InnuendoPi/Spundomat/README.md

# Spundomat

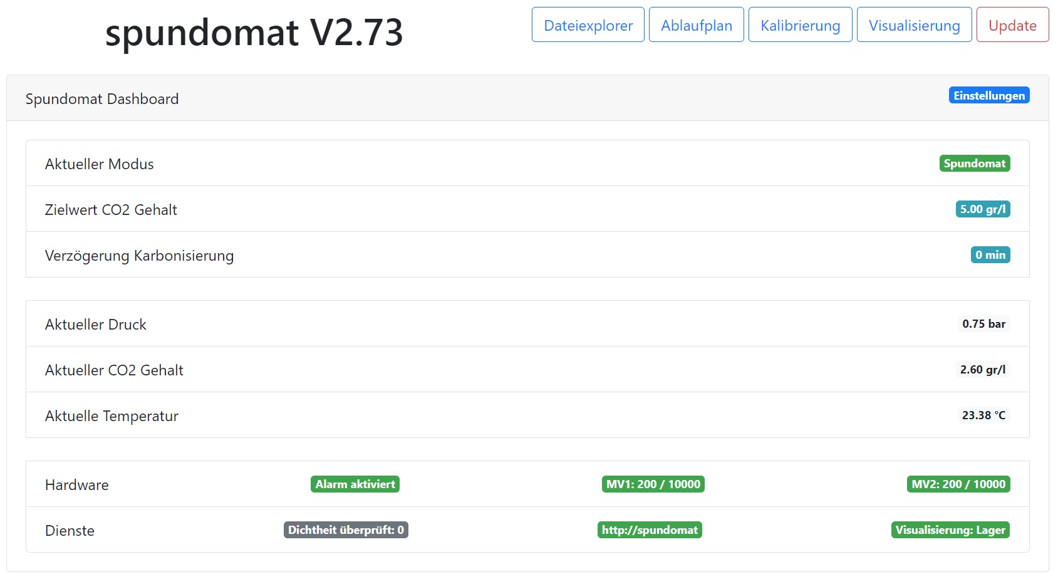
[picture p1: docs/img/Spundomat01.jpg]
ov1


Dokumentation unter: <https://innuendopi.github.io/Spundomat/>

## Infos zum Quellcode

Bibliotheken: (Stand ab Version 2.85, 02.2025)

- ESP8266 3.2 (LittleFS)
- VSCode 1.96 Arduino 0.6 Arduino CLI 1.0.4\
- VSCode plugin ESP8266LittleFS based on ESP8266fs\
- ArduinoJSON 7.2
- InfluxDB 3.13
- WiFiManager 2.0
- LiquidCrystal_PCF8574 2.2
- RotaryEncoder 1.5.3
- InnuTicker
- InnuFramework

Flash size 4MB (FS:2MB OTA:~1019kB)

## Changelog

Version 2.85

- Test:         Modul Steuerung Fermenter reaktiviert
- Update:       Dallas DS18B20 Bibliothek 4.0.3
- Korrektur:    Gehäuse Spundomat 2
- Neu:          Gehäuse Spundomat 2
- Update:       Arduino cores 3.2
- Update:       ArduinoJSON 7.2
- Fix:          Ablaufplan Namen wurden fehlerhaft abgespeichert
- Geändert:     Lesen und Speichern im eeprom überarbeitet (typedef struct)
- Geändert:     Änderungen der Konfiguration im WebIf werden nun als JSON übertragen
- Neu:          Überprüfung aller Eingabe im Web interface (client side validation). Anm.: nicht in den Tabellen Ablaufplan
- Neu:          Zeitserver integriert
- Geändert:     InnuFramework aktualisiert
- Neu:          SerializeJSON jQuery Plugin eingefügt

Version 2.83f

- Update:       ArduinoJSON API 7
- Fix:          Free memory for _currentArgs after request has been handled in WebServer. (#9077)
- Fix:          ESP8266WebServer - fix possible memory leak in request argument handling (#9076)
- Neu:          Display Timeout (User Bierdrohne)
- Fix:          JSON Größe misc
- Fix:          JSON Influx User Password an WebIf fehlerhaft
- Geändert:     Parametertyp Influx User/Bucket und Password/Token
- Fix:          Visualisierung

Version 2.82

- Fix:          WebUpdate

Version 2.81

- Geändert:     WebUpdate Standardverbindung SSL
- Geändert:     Speicherverbrauch WebUpdate optimiert
- Geändert:     DateiUpdate
- Neu:          Log Datei WebUpdate (webUpdateLog.txt)

Version 2.80

- Fix:          github MFLN Verprobung WebUpdate
- Fix:          WebUpdate
- Erneuert:     Zertifikate SSL

Version 2.79 Release

- Update:     InnuFramework

Version 2.78

- Fixed:      Arduino ESP8266 core: Fix for occasional timeout issues #8944 (net error timeout - WebIf Fehler)
- Fixed:      Arduino ESP8266 core: Fix for dangerous relocation: j: cannot encode #8925
- Changed:    Arduino ESP8266 core: Add support WiFiClientSecure TCP KeepAlive #8940
- Changed:    Cache control WebIf (no-cache, expires 0)
- Update:     InnuFramework

Version 2.77

- Update:   ESP8266 cores, Arduino Bibliotheken
- Update:   JQuery 3.7.0
- Fixed:    cache handling
- Fixed:    page load unknown length
- Fixed:    Fehler gpio
- Changed:  GPIO Modus (Piezo, Ventilator) ersetzt durch Pizeo Buzzer ein/aus
- Removed:  alte goto sub statements

Version 2.76

- Optimize: CleanUp, Framework
- Fixed:    Fehler speichern Ablaufplan

Version 2.75

- Optimize: Framework: WLAN reconnect, readConfig

Version 2.74

- Fixed:    Fehler WebIf Visualisierung behoben
- Update:   ESP8266 cores
- Update:   bootstrap 4.6.2
- Optimize: Konfiguration Backup und Restore
- Added:    DevBranch
- Update:   ESP8266 Arduino 3.1.2
- Optimize: Web Interface
- Optimize: Framework
- Update:   VSCode 1.76
