InnuendoPi/Spundomat/docs/img/Ablaufplan1.jpg

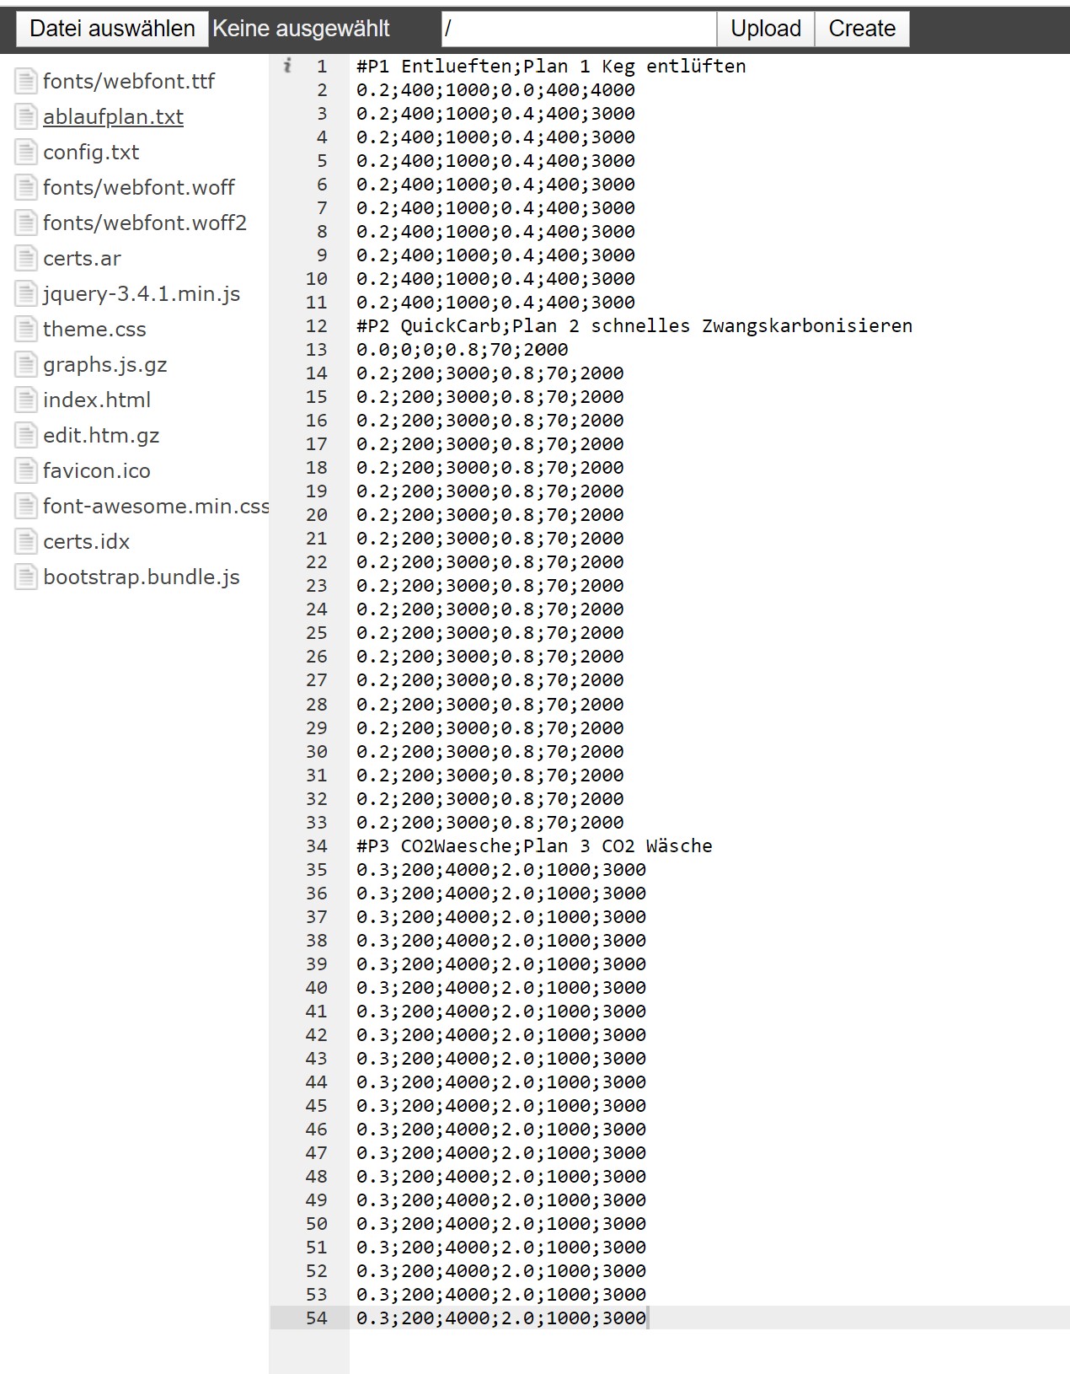
docs/img/Ablaufplan1.jpg
