InnuendoPi/Spundomat/docs/img/co2waesche.jpg

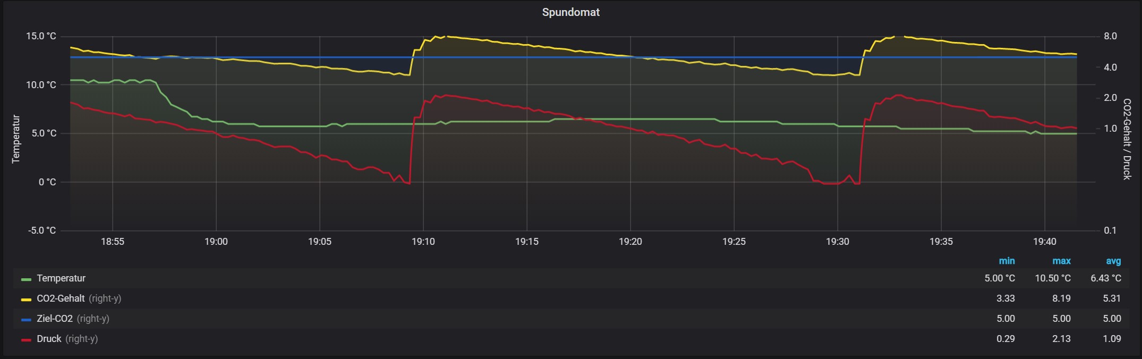
docs/img/co2waesche.jpg
