InnuendoPi/Spundomat/docs/img/P1100002_Bildgröße ändern.JPG

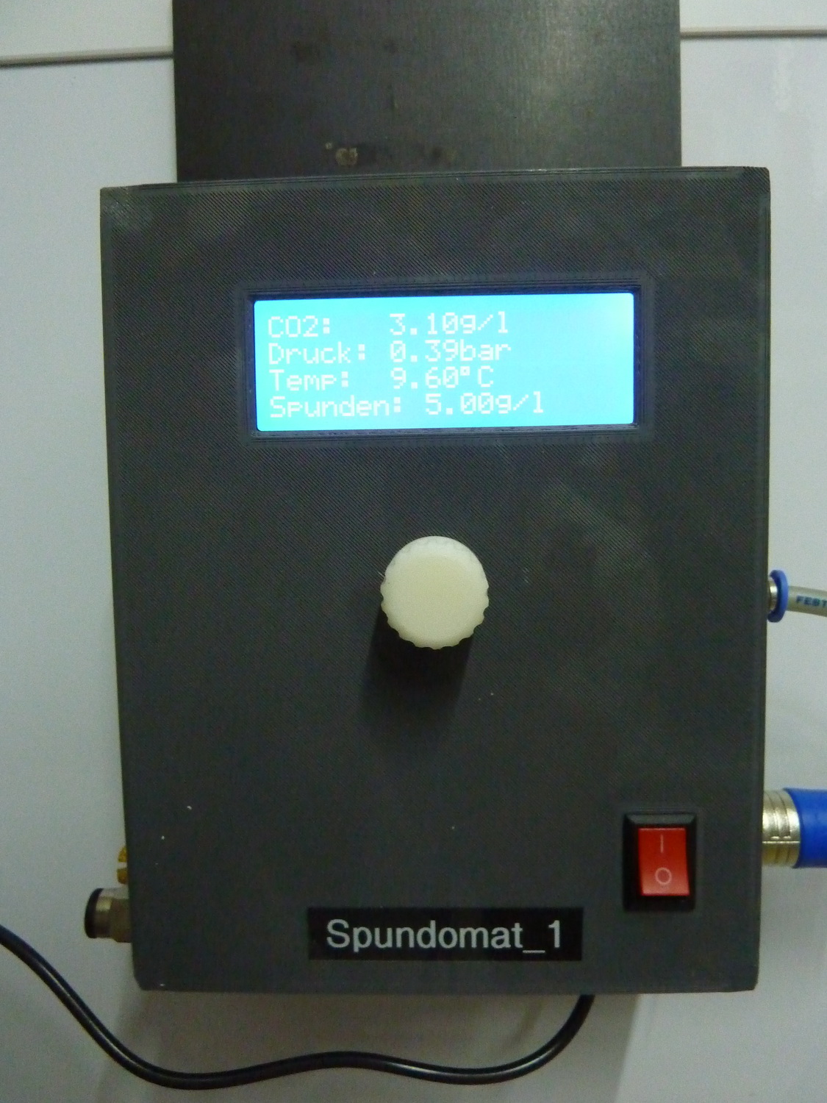
docs/img/P1100002_Bildgröße ändern.JPG
