InnuendoPi/Spundomat/docs/img/P1100003_Bildgröße ändern.JPG

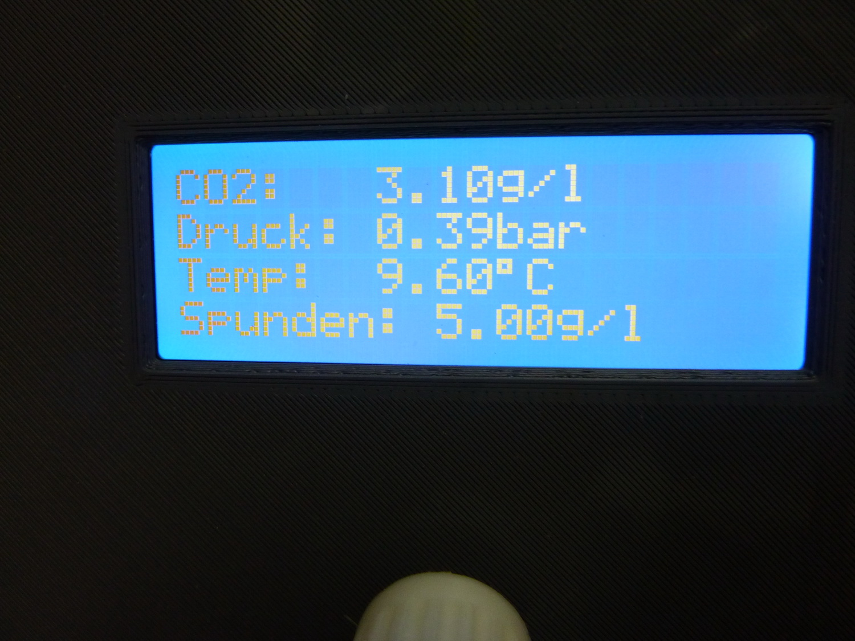
docs/img/P1100003_Bildgröße ändern.JPG
