InnuendoPi/Spundomat/docs/img/P1100004_Bildgröße ändern.JPG

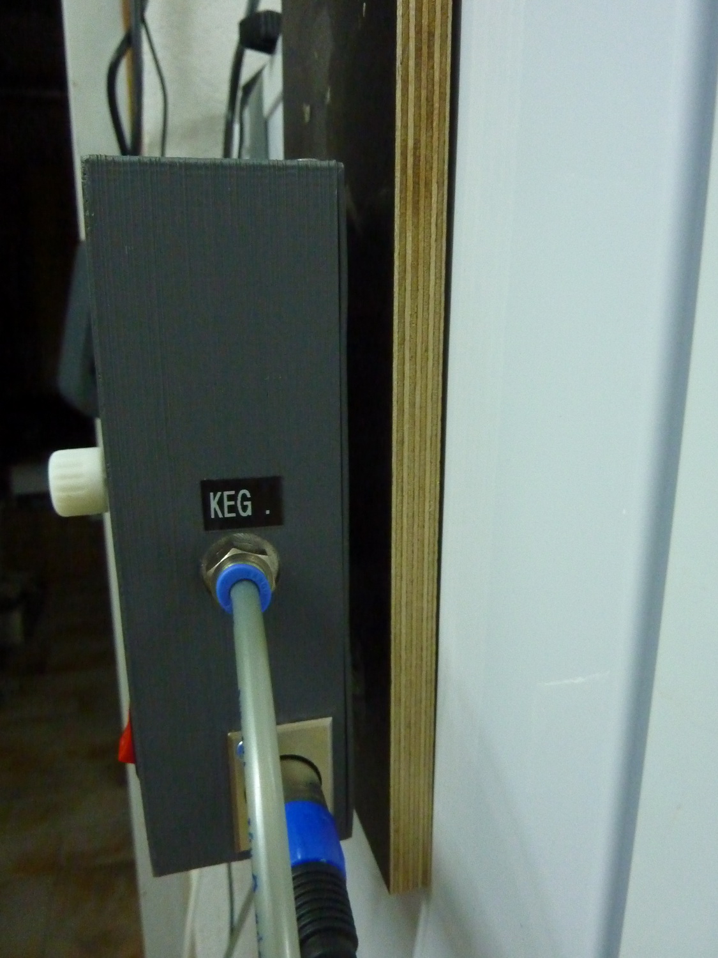
docs/img/P1100004_Bildgröße ändern.JPG
