InnuendoPi/Spundomat/docs/img/quickcarb.jpg

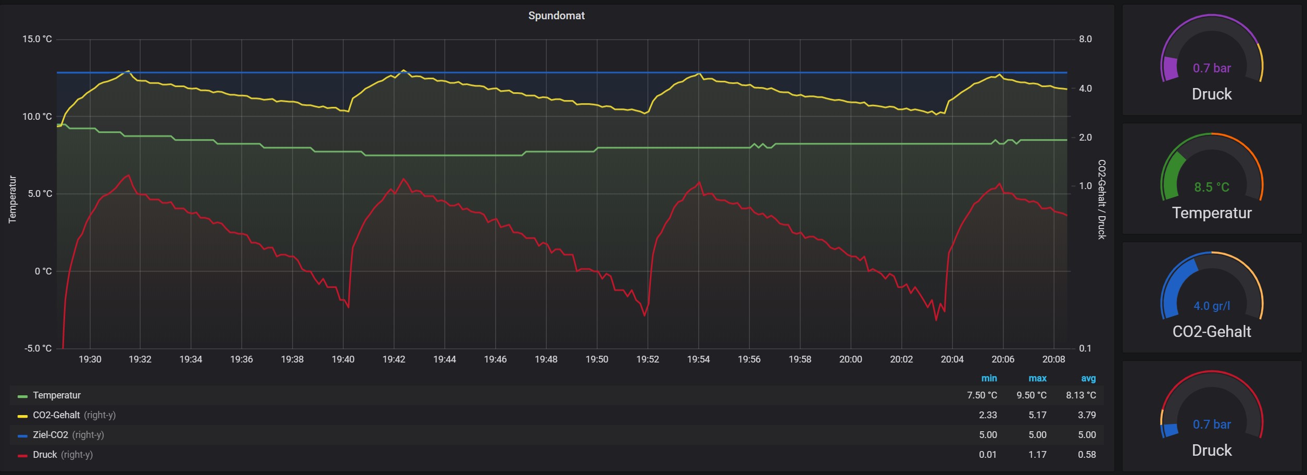
docs/img/quickcarb.jpg
