InnuendoPi/Spundomat/docs/img/Spunder.jpg

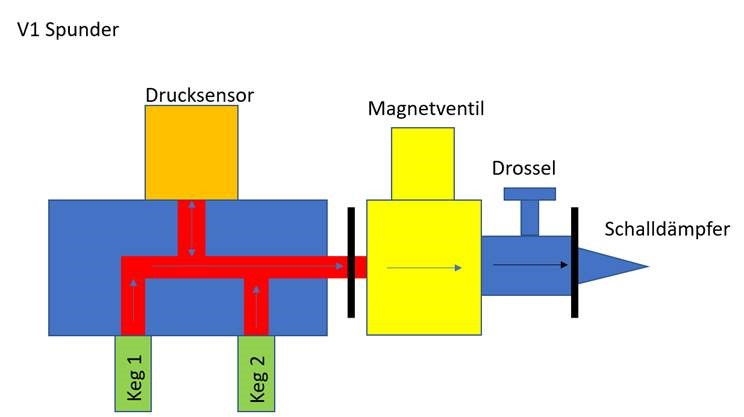
docs/img/Spunder.jpg
