InnuendoPi/Spundomat/docs/img/Zwangskarbonisieren.jpg

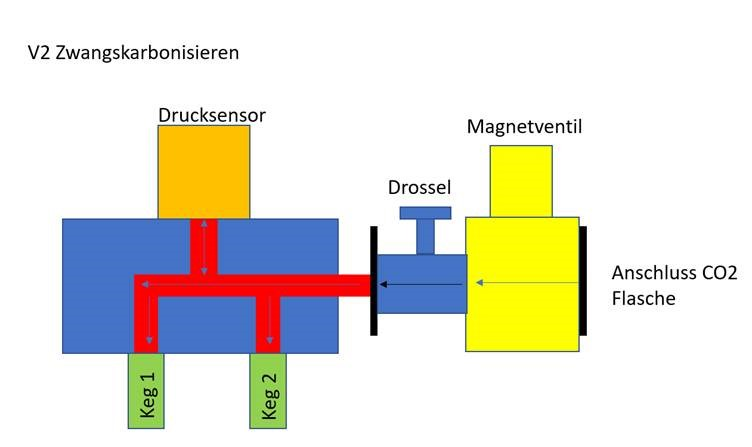
docs/img/Zwangskarbonisieren.jpg
