InnuendoPi/Spundomat/(threads)

Thread 2 (2022-07-30):

MDNS setting flips back to "On"

msbannert, 2022-07-30:
If you disable the MDNS and restart the device, then the MDNS setting flips back to "on".

Seen with V2.62

Looks like there is an issue with the deserialisation of the setting, see also https://arduinojson.org/v6/api/jsonvariant/or/#pitfall-%EF%B8%8F

InnuendoPi, 2022-08-01:
Please try latest 2.64. Feedback welcome

msbannert, 2022-08-01:
V2.64 works fine, the issue is fixed.

Thanks a lot !

Closed 2022-08-01.
