InnuendoPi/Spundomat/ablaufplan_htm.h

const char ablaufplan_htm_gz[] PROGMEM = { 
  0x1f, 0x8b, 0x08, 0x08, 0xae, 0x35, 0x7f, 0x69, 0x04, 0x00, 0x61, 0x62,
  0x6c, 0x61, 0x75, 0x66, 0x70, 0x6c, 0x61, 0x6e, 0x2e, 0x68, 0x74, 0x6d,
  0x00, 0xed, 0x5b, 0x59, 0x8f, 0xd3, 0x30, 0x10, 0xfe, 0x2b, 0xc1, 0x20,
  0x35, 0x11, 0x49, 0x4a, 0x1d, 0x09, 0xa1, 0xd2, 0x14, 0x71, 0xdf, 0x87,
  0x00, 0x21, 0x21, 0xc4, 0x83, 0x37, 0x71, 0x5b, 0x43, 0xea, 0x04, 0xc7,
  0x29, 0xcb, 0xf5, 0xb7, 0x78, 0xe2, 0x8d, 0x3f, 0xc6, 0x8c, 0x73, 0xb4,
  0xd9, 0xb4, 0xa5, 0xe5, 0xdc, 0x87, 0x3e, 0x6c, 0x13, 0xdb, 0xe3, 0xf1,
  0x37, 0x33, 0xf6, 0x67, 0x67, 0x92, 0x1d, 0x9d, 0xb9, 0xf1, 0xf8, 0xfa,
  0xf3, 0x97, 0x4f, 0x6e, 0x5a, 0x33, 0x3d, 0x4f, 0xc6, 0x23, 0xfc, 0xb5,
  0x12, 0x26, 0xa7, 0x61, 0xcc, 0xc7, 0xa3, 0x39, 0xd7, 0xcc, 0x8a, 0x66,
  0x4c, 0xe5, 0x5c, 0x87, 0x85, 0x9e, 0x78, 0x97, 0xc6, 0x23, 0x2d, 0x74,
  0xc2, 0xc7, 0x57, 0x8f, 0x12, 0x56, 0x4c, 0x32, 0x90, 0x1c, 0xf5, 0xb1,
  0xa6, 0x16, 0x96, 0x6c, 0xce, 0xc3, 0x85, 0xe0, 0xef, 0xb3, 0x54, 0x69,
  0x2b, 0x4a, 0xa5, 0xe6, 0x52, 0x87, 0xe4, 0xbd, 0x88, 0xf5, 0x0c, 0x54,
  0x2e, 0x44, 0xc4, 0x3d, 0x53, 0x70, 0x85, 0x14, 0x5a, 0xb0, 0xc4, 0xcb,
  0x23, 0x96, 0xf0, 0x70, 0xe0, 0xe6, 0x33, 0x25, 0xe4, 0x5b, 0x4f, 0xa7,
  0xde, 0x44, 0xe8, 0x50, 0xa6, 0xa4, 0xd4, 0x08, 0xb8, 0x74, 0xe6, 0xf1,
  0x77, 0x85, 0x58, 0x84, 0xd7, 0x59, 0x34, 0xe3, 0xde, 0x75, 0x50, 0xaa,
  0xd2, 0x64, 0xa9, 0x5c, 0xa6, 0x5e, 0x84, 0x2d, 0xae, 0x05, 0x77, 0xb9,
  0x4e, 0x15, 0xdc, 0xcd, 0x8b, 0x5c, 0x7b, 0x8a, 0x2f, 0x58, 0x22, 0x62,
  0xa6, 0xf9, 0x1a, 0x65, 0x4f, 0x14, 0x9b, 0xce, 0x59, 0xa3, 0xa5, 0x56,
  0xd2, 0x15, 0xbc, 0x79, 0x9c, 0x09, 0xc5, 0xf3, 0x46, 0xf2, 0xc2, 0x8a,
  0xa9, 0x60, 0x52, 0x1e, 0x29, 0x91, 0x69, 0x91, 0xca, 0x25, 0xa0, 0x67,
  0x59, 0x21, 0xe3, 0x74, 0xce, 0xb4, 0x65, 0xee, 0xb8, 0xb4, 0xe0, 0xd7,
  0xba, 0xcf, 0xd4, 0x51, 0x2a, 0x45, 0x2e, 0xb8, 0xe2, 0x92, 0xac, 0x2a,
  0x61, 0x85, 0x9e, 0xa5, 0xaa, 0xe9, 0x7f, 0x57, 0xca, 0x82, 0x83, 0x82,
  0xf1, 0x28, 0x01, 0x8f, 0x58, 0x8a, 0x27, 0x61, 0xae, 0x3f, 0x24, 0x3c,
  0x9f, 0x71, 0xae, 0xad, 0x99, 0xe2, 0x93, 0xb0, 0x9f, 0xd7, 0x43, 0xf8,
  0x73, 0x21, 0xfd, 0x28, 0xcf, 0xc7, 0xa3, 0x12, 0x88, 0x95, 0xab, 0xe8,
  0x64, 0xf3, 0x1b, 0x68, 0xed, 0x97, 0xcd, 0xe3, 0xd1, 0x51, 0x1a, 0x7f,
  0xb0, 0x52, 0x99, 0xa4, 0x2c, 0x0e, 0x21, 0xac, 0x77, 0x61, 0x4c, 0x05,
  0x6e, 0xb2, 0x41, 0xad, 0x82, 0x21, 0x5c, 0xca, 0x03, 0x67, 0x3c, 0x8a,
  0xc5, 0xc2, 0x12, 0x71, 0xf8, 0x5e, 0xb1, 0x2c, 0xe3, 0xaa, 0x2c, 0x47,
  0x09, 0xcb, 0xf3, 0x90, 0xc4, 0xde, 0x24, 0xe1, 0xc7, 0x16, 0xfe, 0x78,
  0x51, 0x9a, 0x14, 0x73, 0x49, 0x50, 0xb4, 0x42, 0xef, 0xad, 0x76, 0x59,
  0xd6, 0xc3, 0xc0, 0x92, 0x35, 0x2a, 0xe0, 0xf6, 0x88, 0x29, 0xab, 0xbc,
  0x78, 0x89, 0x98, 0xce, 0x74, 0x5d, 0xe0, 0xc7, 0x19, 0x93, 0xb1, 0x37,
  0x8f, 0xb1, 0x42, 0x4c, 0x19, 0x7a, 0xd6, 0x8b, 0x12, 0xce, 0xa4, 0x77,
  0x54, 0x68, 0x9d, 0x4a, 0xb2, 0x02, 0xc6, 0x28, 0x67, 0x42, 0xe2, 0x70,
  0xac, 0xaa, 0xaa, 0xf4, 0x1c, 0x29, 0x50, 0x53, 0x39, 0x4b, 0x40, 0x0c,
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
};
unsigned int ablaufplan_htm_gz_len = 2325;
