InnuendoPi/Spundomat/index_htm.h

const char index_htm_gz[] PROGMEM = { 
  0x1f, 0x8b, 0x08, 0x08, 0xad, 0x35, 0x7f, 0x69, 0x04, 0x00, 0x69, 0x6e,
  0x64, 0x65, 0x78, 0x2e, 0x68, 0x74, 0x6d, 0x00, 0xdd, 0x1d, 0xd9, 0x92,
  0xdb, 0x44, 0xf0, 0x57, 0x26, 0x82, 0x02, 0x1b, 0x2c, 0x1f, 0xda, 0x5d,
  0x0e, 0xc7, 0x72, 0x2a, 0xc9, 0x72, 0x04, 0xc8, 0x26, 0xc5, 0x2e, 0x50,
  0x10, 0x20, 0x35, 0xb2, 0xc6, 0xf6, 0xb0, 0xb2, 0x24, 0x74, 0xec, 0x11,
  0xd8, 0xef, 0xe0, 0x85, 0x2a, 0x5e, 0xf8, 0x00, 0x9e, 0x78, 0xe2, 0x89,
  0xfd, 0x31, 0x7a, 0x0e, 0x69, 0x74, 0xda, 0xf2, 0x45, 0x02, 0x54, 0xb1,
  0x58, 0xa3, 0x9e, 0x9e, 0xbe, 0xa7, 0x67, 0xa6, 0x47, 0x8c, 0xee, 0x1c,
  0x3f, 0x79, 0x78, 0xf6, 0xf5, 0xd3, 0x0f, 0xd0, 0x3c, 0x5a, 0x38, 0xe3,
  0x11, 0xfb, 0x8b, 0x1c, 0xec, 0xce, 0x4c, 0x9b, 0x8c, 0x47, 0x0b, 0x12,
  0x61, 0x34, 0x99, 0xe3, 0x20, 0x24, 0x91, 0x19, 0x47, 0x53, 0xfd, 0x3d,
  0xd9, 0xe6, 0xe2, 0x05, 0x31, 0x2f, 0x28, 0xb9, 0xf4, 0xbd, 0x20, 0x42,
  0x13, 0xcf, 0x8d, 0x88, 0x1b, 0x99, 0xda, 0x25, 0xb5, 0xa3, 0x39, 0xf4,
  0xbc, 0xa0, 0x13, 0xa2, 0xf3, 0x87, 0x0e, 0x75, 0x69, 0x44, 0xb1, 0xa3,
  0x87, 0x13, 0xec, 0x10, 0x73, 0xd0, 0x09, 0xe7, 0x01, 0x75, 0xcf, 0xf5,
  0xc8, 0xd3, 0xa7, 0x34, 0x32, 0x5d, 0x4f, 0x13, 0x18, 0x61, 0xf8, 0xc8,
  0xd7, 0xc9, 0x8f, 0x31, 0xbd, 0x30, 0xaf, 0xf4, 0x18, 0xeb, 0x13, 0x6f,
  0xe1, 0xe3, 0x88, 0x5a, 0x0e, 0x51, 0xe8, 0x29, 0x31, 0x89, 0x3d, 0x23,
  0x15, 0x5d, 0x1e, 0xe2, 0xc9, 0x9c, 0xe8, 0x0f, 0x01, 0x30, 0xf0, 0x1c,
  0xd5, 0xc1, 0xf5, 0xf4, 0x09, 0x7b, 0xd3, 0x41, 0xf0, 0x2b, 0x8c, 0xbc,
  0x00, 0x7e, 0x2d, 0xe2, 0x30, 0xd2, 0x03, 0x72, 0x81, 0x1d, 0x6a, 0xe3,
  0xa8, 0x0a, 0xd9, 0xd3, 0x00, 0xcf, 0x16, 0x38, 0xc5, 0x92, 0x20, 0x29,
  0x03, 0x7e, 0x70, 0xe5, 0xd3, 0x80, 0x84, 0x29, 0x64, 0x3f, 0x2b, 0x1d,
  0x9b, 0x84, 0x93, 0x80, 0xfa, 0x11, 0xf5, 0x5c, 0x45, 0xd0, 0xa9, 0x1f,
  0xbb, 0xb6, 0xb7, 0xc0, 0x11, 0xe2, 0xbf, 0x88, 0x8b, 0xe0, 0x2f, 0xfa,
  0x14, 0x07, 0x96, 0xe7, 0xd2, 0x90, 0x92, 0x80, 0xb8, 0x5a, 0x16, 0x09,
  0x8e, 0xa3, 0xb9, 0x17, 0xa4, 0xfd, 0x1f, 0xb9, 0x6e, 0x4c, 0x00, 0xc1,
  0x78, 0x14, 0xd1, 0xc8, 0x21, 0xe3, 0x14, 0xdd, 0xa8, 0x27, 0x1a, 0x46,
  0x0e, 0x08, 0x17, 0x05, 0xc4, 0x31, 0xc3, 0xe8, 0xda, 0x21, 0xe1, 0x9c,
  0x90, 0x08, 0xcd, 0x03, 0x32, 0x35, 0x7b, 0x61, 0x02, 0xdb, 0x5d, 0x50,
  0xb7, 0x3b, 0x09, 0xc3, 0xf1, 0x48, 0x10, 0x88, 0xc2, 0x60, 0x52, 0x7c,
  0xfd, 0x03, 0xbc, 0xed, 0x89, 0xd7, 0xe3, 0x91, 0xe5, 0xd9, 0xd7, 0xc8,
  0x73, 0x1d, 0x0f, 0xdb, 0x26, 0x18, 0xc2, 0x23, 0xa0, 0x25, 0x00, 0xf1,
  0xb5, 0x00, 0x6d, 0x00, 0x43, 0x74, 0x0e, 0xc8, 0x41, 0x7b, 0x3c, 0xb2,
  0xe9, 0x05, 0x9a, 0x38, 0x38, 0x0c, 0x4d, 0xff, 0x5a, 0x37, 0xb2, 0xcf,
  0x8c, 0x7a, 0x4c, 0x5d, 0x12, 0x64, 0x1b, 0x03, 0xef, 0x32, 0x0f, 0x03,
  0xc6, 0x87, 0x25, 0xa9, 0x14, 0x24, 0x73, 0x25, 0x5f, 0x68, 0x56, 0xe4,
  0x22, 0xf8, 0x57, 0xf7, 0xe2, 0xc8, 0x01, 0x24, 0x3a, 0xe3, 0x50, 0x43,
  0xd4, 0x36, 0xa7, 0x34, 0x58, 0x5c, 0xe2, 0x80, 0x00, 0xa5, 0x18, 0xfe,
  0x05, 0x5c, 0x05, 0x84, 0xfa, 0xc2, 0xd6, 0x41, 0x80, 0x9e, 0x42, 0x4c,
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
};
unsigned int index_htm_gz_len = 5111;
