InnuendoPi/Spundomat/6_CALC.ino

/**
 * Carbonation tables show the CO2 content of the beer based on the beer 
 * temperature and CO2 head pressure once an equilibrium has been reached. 
 * Using this formula [HOBBYBRAUER]:
 * 
 * Cbeer = (Phead+1.013)*(2.71828182845904^(-10.73797+(2617.25/(Tbeer+273.15))))*10
 * Cbeer - carbonation of the beer in g/l
 * Phead - head pressure in bar
 * Tbeer - temperature of the beer in C
 * 
 * http://braukaiser.com/wiki/index.php/Carbonation_Tables
**/

// Berechne CO2 gehalt
float calcCarbonation(const float &localPress, const float &localTemp)
{
	if (localTemp == 85.0 || localTemp == -127.00)
		return 0.0;
	else if (psettings.offset0 == 0.0 && psettings.offset2 == 0.0)
		return 0.0;
	return ((localPress + 1.013) * pow(E, (-10.73797 + (2617.25 / (localTemp + 273.15)))) * 10);
}

// Berechne Solldruck
float calcPressure(const float &localCarb, const float &localTemp)
{
	if (localTemp == 85.0 || localTemp == -127.00)
		return 0.0;
	else if (psettings.offset0 == 0.0 && psettings.offset2 == 0.0)
		return 0.0;
	return ((localCarb / 10) / pow(E, (-10.73797 + (2617.25 / (localTemp + 273.15)))) - 1.013);
}
