InnuendoPi/Spundomat/99_PINMAP.ino

/* PINMAP
  0   D3        OnewWire DS18B20
  1
  2   D4        Encoder Button SW
  3
  4   D2        Display SDA
  5   D1        Display SCL
  6
  7
  8
  9   UNUSED
  10
  11
  12  D6        Encoder A CLK Out A
  13  D7        Buzzer od. Relais
  14  D5        Encoder B DT Out B
  15  D8        Magnetventil 1
  16  D0        Magnetventil 2
 */
