InnuendoPi/Spundomat/(commit log)

2020-03-22 Gerber files
2020-05-15 Gerber Dateien 6.0
2020-07-19 Update Gerber 6.01
2020-07-27 Gerber 6.01
2020-10-16 Gerber 6.02
2024-11-15 V 2.84
    [zones.csv]
